VivaanRao-crisp/autoRAD/iteration_log.md

# Iteration log (CLAUDE.md rule 4)

Earlier changes (design-study revisions 1–3) are in `CHANGELOG.md`. From here on, every design
change goes in this file: date, what changed, why, which part to reprint.

| date | what changed | why | reprint |
|---|---|---|---|
| 2026-11-10 | Architecture D kinematics verified before CAD (`kinematics_D.py`, `docs/kinematics_D_report.md`, plots in `docs/img/`). Arm 70.0 → **70.3 mm**, link 60 → **70 mm**, arm elevation at closed 0 → **25°**; carriage moves **down** on payout (fixed pulleys below the carriage); carriage pulleys 2 rows of 2 (70 mm), not 4 in a row (150 mm > 149 mm housing). | Start values gave 32.4 mm of carriage travel (stop at 259 mm, not 300) and a 13.6 % non-linear mapping; joint direction in buildability.md was a sign error. | nothing printed yet |
| 2026-11-10 | 3D stack re-ordered to arm R / link R / link L / arm L (`D_STACK`); grips brought to a common plane z = 14.45 by 10.45 mm hub extensions; reeving changed to crossed axles (moving pulleys axle along x, fixed along z), carriage block 98 mm, cable depth z 21-59; params: bearing 625ZZ defaults, pins/bosses, lanes, E marked legacy | reported stack put joint pins through the far arm (-9.6 mm); 2x2 in-plane reeving forms a closed loop; see docs/kinematics_D_report.md addendum | nothing printed yet |
| 2026-11-10 | OPEN: hand envelope (R35 assumption) overlaps the pivot hub by 12.9 mm; arm joint below the pivot line at full open. Proposals P1-P3 in the report; verified geometry unchanged pending review | check3d_D.py grip check | - |
| 2026-11-10 | Freeze run: arm elevation 25 -> 40 deg, arm 70.3 -> 72.75 (re-solved), hub R20 -> R10, cable z centre 43, fairlead pulley F0 + dead end at the fixed end, spring above the carriage, rods at x +/-57. NOT FROZEN: mapping 2.86 % > 2.5 %, spring-beside does not fit (moved above), depth 72 > 70. Fixes proposed in docs/design_freeze.md | reviewer instructions + stop conditions | nothing printed yet |
| 2026-11-10 | Applied defaults: arm elevation 40 -> 38 deg (arm 72.75 -> 72.05 mm, mapping error 2.86 % -> 2.4 %, PASS), pulley width 8 -> 7 mm (depth 71.5 mm, not 70). CAD route changed: instructor rejects Python files, team builds parametric model in GUI CAD; docs/cad_build_guide.md written. New issue found: pivot bolt M8 vs 625 bearing bore 5 (use plain hub or 608) | user decisions; freeze run stop conditions | nothing printed yet |
| 2026-11-10 | FINAL bench rig: n 8 -> 4 cord parts (3 x 625 bearings as pulleys), arm 72.05 -> 125.9 mm, elevation 38 -> 42 deg, link 70 -> 120 mm, carriage travel 37.5 -> 75 mm; one-piece handles (hub + drive arm + long arm + grip pad); cord system moved BEHIND the board (links sweep the fixed-standoff zone in front); carriage = Gamma plate on two bolts in two board slots; housing, anchor spring, guide rods, 7 printed pulleys dropped; 16 printed pieces from 5 models | manufacturer: too many parts; project is a proof of concept (PDF section 6, slide 12) | nothing printed yet |
| 2026-11-10 | STL / STEP export of the 5 bench models (`cad/bench_parts.py` → `exports/`, `parts_list.md`), with an STL acceptance check (`cad/check_stl.py`) and a 44-body assembly interference check (`cad/bench_assembly.py`, output in `out/`). Two changes against design_spec.md §2: **(1) handle: 90° countersink Ø11 on the back face of the joint hole** (joint pins become M5 countersunk screws); **(2) carriage: band hook = two Ø4 holes at (4, 54.5) and (4, −5.5)** instead of a notch at (8, 65). Both are ASSUMPTION values in `params.py`. | (1) handle R lies flat on the board, so a joint-pin head or nut behind it would be inside the board (the earlier 3D check had no board in it). (2) a Ø4 hole does not fit at the spec corner next to the guide-bolt hole, and from there the band is only ~12 mm long at closed (6× stretch to the stop); the lower hole gives ~73 → ~148 mm. | nothing printed yet |
| 2026-11-10 | OPEN, found by the assembly check, NOT changed: (a) right arm passes the left-handle spacer (OD 24) with **0.51 mm** at full open — bench_check 3b measured to the bolt (8.5 mm), not the spacer; (b) flange washers overlap the carriage post by 0.5 mm each (post leaves 0.5 mm per side, the stack needs flange 1 mm + washer); (c) F1 / F0 standoff lengths ignore the 1 mm flange, bearings sit 1 mm behind the lane plane; (d) wall beside the carriage pin hole is 1.35 mm (rule: ≥ 1.6); (e) handle bed footprint is 167 × 167, not "118 × 176". | see `out/bench_assembly_run.txt` | decide before printing |
