VivaanRao-crisp/autoRAD/docs/buy_list.md

# autoRAD bench rig — buy list

Everything is hardware-store grade; no part numbers. Quantities include no spares — add 20 %.
Where delivery is a risk, the "local substitute" column works for a bench demo.

| # | Item | Spec | Qty | Local substitute if unavailable |
|---|---|---|---|---|
| 1 | Ball bearing | 625ZZ, 5 × 16 × 5 mm | 3 (+1 spare) | 626 (6 × 19 × 6) with M6 axles and bores changed to 6.3 — tell the CAD people; or printed plain pulleys (more friction) |
| 2 | Bolt M8 × 35, hex, with nut + 2 washers | pivot R | 1 | any M8 ≥ 30 |
| 3 | Bolt M8 × 50, hex, with nut + 2 washers | pivot L (through the 20.9 spacer) | 1 | any M8 ≥ 45 |
| 4 | Bolt M5 × 50, **flat/countersunk or button head** | carriage pin, F0 | 2 | M5 × 45–55 |
| 5 | Bolt M5 × 70, **flat head** | F1 | 1 | M5 × 65–75 |
| 6 | Bolt M5 × 45, flat head | dead end | 1 | M5 × 40–50 |
| 7 | Bolt M5 × 35 | carriage axle | 1 | M5 × 30–40 |
| 8 | Bolt M5 × 30 | guide bolt 2 | 1 | M5 × 25–35 |
| 9 | Bolt M5 × 25, **countersunk head** | joint pins (head flush in the handle's countersink, see design_spec §8a) | 2 | M5 × 20–30 countersunk |
| 10 | Nut M5 (nyloc preferred) | | 10 | plain nuts + a drop of glue |
| 11 | Washer M5 | | 10 | |
| 12 | Braided cord | 1–2 mm, low stretch (fishing braid, kite line, thin paracord) | 2 m | any thin non-stretch string |
| 13 | Rubber band / light bungee | 2–5 N pull over ~80 mm stretch | 3 | hair ties, chained rubber bands |
| 14 | Wooden dowel | Ø20 × 130 mm | 2 | broom handle offcut, PVC pipe Ø20–25 |
| 15 | Wood screws | 3.5 × 16 (dowel to grip pad) + 1 × (band screw) | 5 | |
| 16 | Board | plywood 12 mm (or acrylic 10 mm), 200 × 290 mm | 1 | MDF 12 mm; a cut-down shelf |
| 17 | Printing filament | PETG or PLA, ~110 g | — | |
| 18 | Anchor | a hook, door handle or shelf bracket above the bench to tie the cord to | 1 | a second person holding the cord |

Tools: drill with Ø5.5 and Ø8.5 bits (slots: drill a row of Ø5.5 holes and file to 5.3 wide, or
route), hacksaw, screwdrivers, M5/M8 spanners, ruler, protractor, a spring balance 0–10 N if you
can (for the force measurement; a kitchen scale pulling the cord works too).

If the bearings cannot be sourced in time: print plain pulleys Ø16 × 7 with a Ø5.3 bore on the
same bolts (the CAD people add one model). Friction rises; the demo still works.
