VivaanRao-crisp/autoRAD/autoRAD_Illustrations_Enhanced (1).pptx

IIT KANPUR / DEPARTMENT OF DESIGN

autoRAD

Automatically Articulating V-Bar Attachment
Travel-actuated main concept + spring-based Alpha iteration

Prasun Shrivastav · 230778 Suryansh Rastogi · 231059
Parth Arya Bhat · 230737 Preet Mehta · 230789
Vivaan Rao · 251192 Kamal Sahu · 261190605

01 / autoRAD

## Slide 2

DES649 / PROJECT PROPOSAL

The design opportunity

Rigid V-bar

Stable grip, but the included angle stays fixed throughout the pushdown.

Triceps rope

Hands can separate, but the motion is not mechanically guided.

Our objective

Guide both handles to open symmetrically as the attachment travels downward.

02 / autoRAD

## Slide 3

DES649 / PROJECT PROPOSAL

Problem statement & user need

A cable-machine user needs a stable attachment that accommodates changing hand positions during a pushdown, without a separate manual adjustment.

Design goals: automatic opening • symmetric movement • reversible operation • removable mounting

03 / autoRAD

## Slide 4

DES649 / PROJECT PROPOSAL

Concept evolution: Alpha → selected

ALPHA / spring-based

Self-contained articulated V-bar. User-generated outward force opens the handles against a torsion spring. Meshing gears synchronize the arms.
Simpler packaging, but not driven by pushdown position.

MAIN / travel-actuated

A frame-referenced secondary cable rotates a spool as the attachment moves downward. A linkage opens the handles symmetrically.
Return spring takes up slack during upward travel.

04 / autoRAD

## Slide 5

DES649 / PROJECT PROPOSAL

ALPHA / spring-resisted articulation

Concept A: user-driven opening; spring resists opening and returns arms on release.

WHAT DRIVES OPENING?

Outward force from the user

Meshing gears keep left/right handle motion symmetric.

Torsion spring supplies resistance and return torque — not displacement sensing.

REST / CLOSED

USER OPENS

45° preliminary

~110° preliminary

05 / autoRAD

## Slide 6

DES649 / PROJECT PROPOSAL

MAIN / travel-actuated opening

The spring rewinds / takes up secondary-cable slack as the attachment moves upward.

The fixed reference cable — not the return spring — couples machine travel to handle angle.

01 FRAME REFERENCE

Secondary cable terminates at a fixed anchor.

02 RELATIVE TRAVEL

Moving housing pulls cable from its spool.

03 ROTARY DRIVE

Spool turns the geared transmission.

04 HANDLE OPENING

Both handles flare symmetrically.

RETURN PATH

06 / autoRAD

## Slide 7

DES649 / PROJECT PROPOSAL

MAIN / mechanism & cable routing

Functional schematic — proportions, anchor height and cable path are conceptual until CAD verification.

MOVING HOUSING

PRIMARY CABLE

Fixed anchor

Provides displacement reference.

1

SECONDARY REFERENCE CABLE

SPOOL

DOWNWARD
TRAVEL

Spool + gearing

Converts payout to twin-handle rotation.

2

FIXED FRAME

Return spring

Rewinds slack during upward return.

3

07 / autoRAD

## Slide 8

DES649 / PROJECT PROPOSAL

MAIN / complete working cycle

Movement diagram emphasizes what moves, what stays fixed, and the return mechanism.

01 TOP

Cable wound

02 EARLY PUSH

Payout begins

03 MID STROKE

Spool rotates

04 BOTTOM

Opening limited

05 RETURN

Spring takes up

08 / autoRAD

## Slide 9

DES649 / PROJECT PROPOSAL

Opening angle increases with pushdown travel

Illustrative kinematic states: angle mapping requires spool diameter and gear-ratio calibration.

TOP OF STROKE

45°

MID-STROKE

80°

BOTTOM OF STROKE

110°

09 / autoRAD

## Slide 10

DES649 / PROJECT PROPOSAL

Preliminary design requirements

Geometry & travel

Included angle: approximately 45° to 110°
Travel: approximately 20–40 cm
Housing width target: ≤ 140 mm

Performance & safety

Symmetric handle motion
Actuation resistance goal: ≤ 10 N
Removable attachment; no frame drilling
Mechanical stops and guarded moving parts

10 / autoRAD

## Slide 11

DES649 / PROJECT PROPOSAL

Engineering challenges to resolve

Cable path

Avoid snagging and interference; ensure repeatable spool payout and take-up.

Human factors

Avoid forcing wrist motion; account for user height and stroke variation.

Mechanical integrity

Evaluate friction, backlash, gear loads, bearing support and safe end stops.

11 / autoRAD

## Slide 12

DES649 / PROJECT PROPOSAL

CAD → prototype → validation

CAD deliverables

Parametric assembly, exploded view, sectional views, spool sizing, gear ratio, clearance and motion study.

Physical validation

Low-load bench rig with fixed reference anchor; measure angle vs travel, actuation force, symmetry, return reliability and cable interference.

12 / autoRAD

## Slide 13

DES649 / PROJECT PROPOSAL

Comparative evaluation of both concepts

Alpha baseline

Measure manually applied opening force, spring torque, return repeatability and synchronization.

Selected main concept

Measure displacement-to-angle mapping, automatic opening, cable routing reliability and return take-up.

Compare on complexity, manufacturability, controllability, safety and user comfort.

13 / autoRAD

## Slide 14

DES649 / PROJECT PROPOSAL

Prior art, evidence & claims

Known: adjustable V-bars, ropes and swivel handles exist. Earlier proposal references US20200114193A1, US20020068666A1 and US5921902A.

Hypothesis: frame-referenced travel-to-opening actuation may distinguish this concept. Novelty, patentability and ergonomic benefits are NOT established.

Rendos et al. (2016), PMID 26694502: tested other handle conditions; does not validate autoRAD.

14 / autoRAD

## Slide 15

DES649 / PROJECT PROPOSAL

Project roadmap & deliverables

01 Model both alternatives and select linkage parameters
02 Simulate motion, packaging, interference and loading
03 Fabricate low-load Alpha and travel-actuated prototypes
04 Test → identify failure modes → revise CAD → retest
05 Deliver prototype, drawings, measurements and final report

DES649 requires a physical prototype and documented iteration; this presentation is a proposal, not a tested result.

15 / autoRAD

## Slide 16

DES649 / PROJECT PROPOSAL

autoRAD / design proposal

MAIN DESIGN
Secondary-cable, distance-based automatic opening

ALPHA DESIGN
Self-contained, spring-resisted articulation

16 / autoRAD
