VivaanRao-crisp/autoRAD/docs/img/bench_P1_handle.png

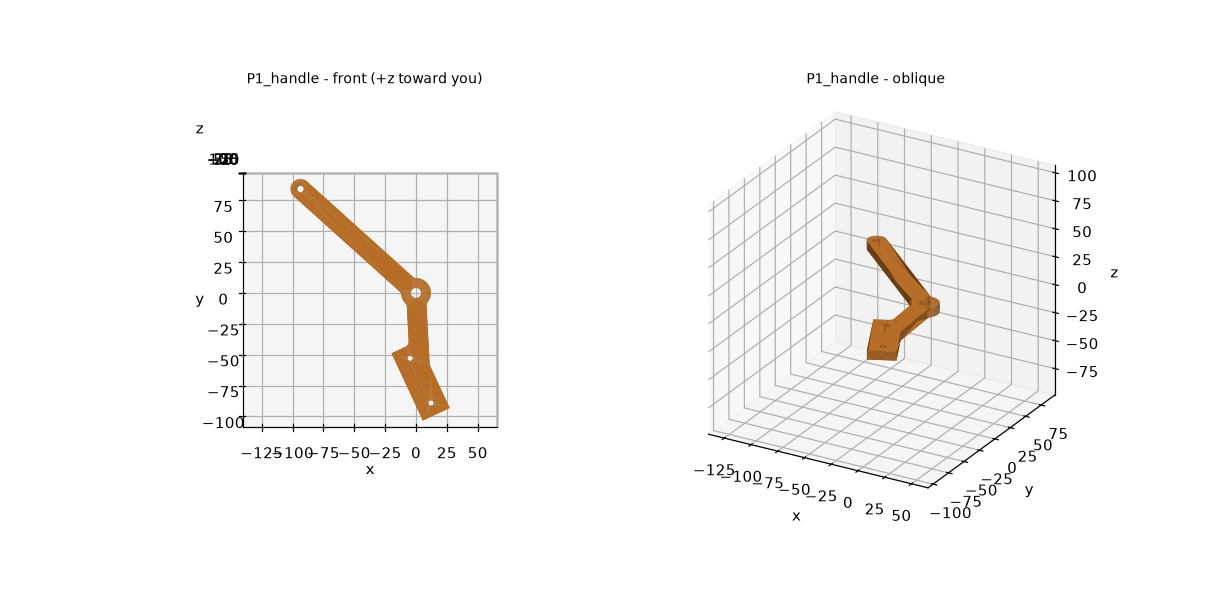
docs/img/bench_P1_handle.png
