VivaanRao-crisp/autoRAD/docs/img/bench_P2_link.png

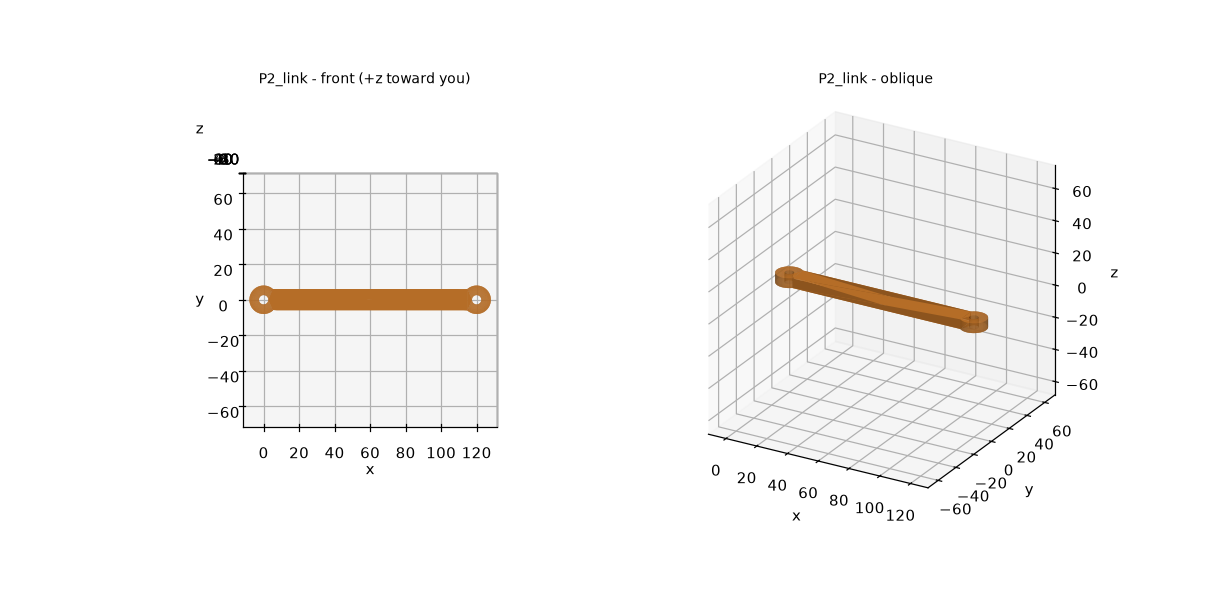
docs/img/bench_P2_link.png
