VivaanRao-crisp/autoRAD/docs/img/D_angle_vs_travel.png

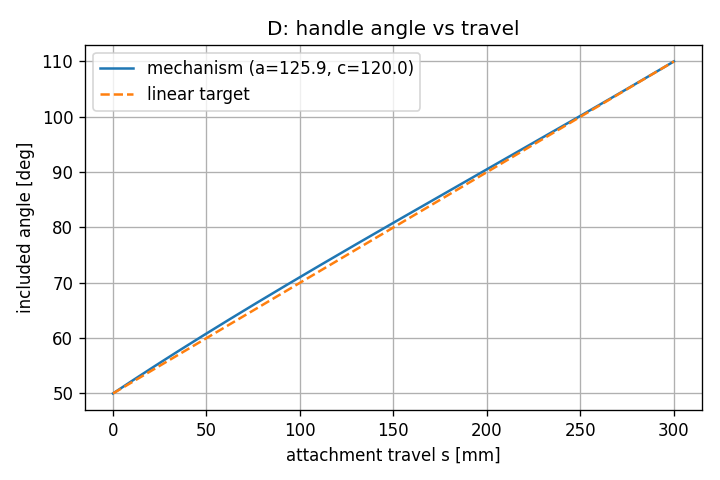
docs/img/D_angle_vs_travel.png
