VivaanRao-crisp/autoRAD/docs/img/D_cable_tension_vs_travel.png

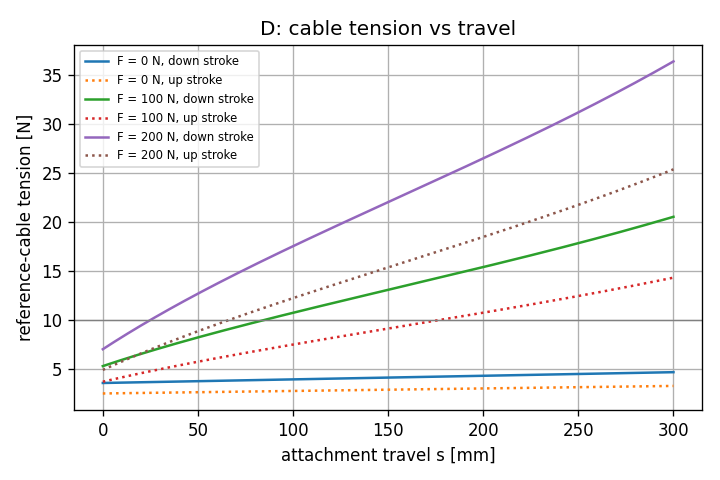
docs/img/D_cable_tension_vs_travel.png
