VivaanRao-crisp/autoRAD/docs/img/D_torque_vs_travel.png

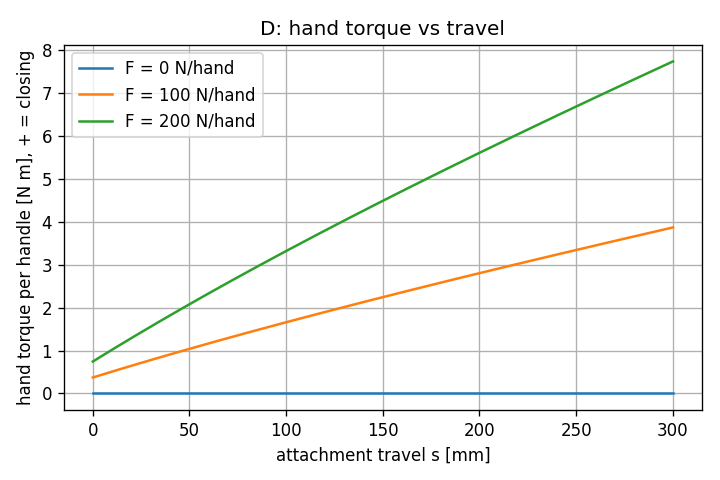
docs/img/D_torque_vs_travel.png
