VivaanRao-crisp/autoRAD/docs/img/D_transmission_angle_vs_travel.png

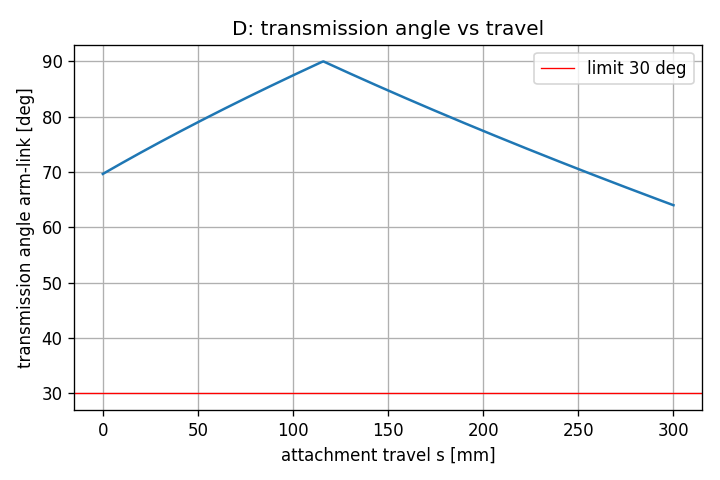
docs/img/D_transmission_angle_vs_travel.png
