VivaanRao-crisp/autoRAD/exports/step/assembly_closed.step

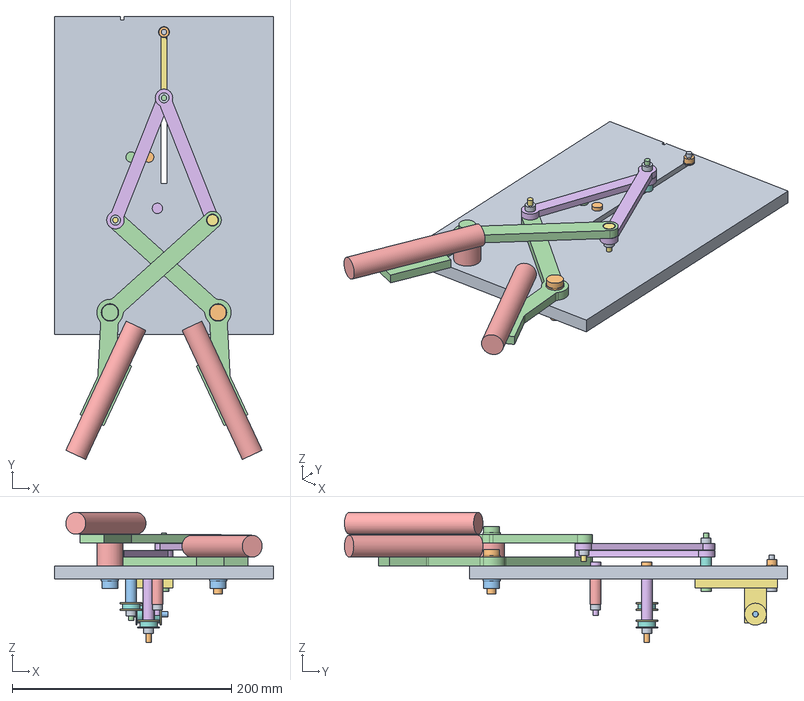
[picture p7: CAD file, 2026-11-11]
exports/step/assembly_closed.step
200.0 x 404.1 x 118.9 mm
board
pivot_R_bolt
pivot_R_nut
pivot_L_bolt
pivot_L_nut
spacer_handleL
F1_standoff
F1_flange_a
F1_bearing
F1_flange_b
F1_nut
F1_bolt
F0_standoff
F0_flange_a
F0_bearing
F0_flange_b
F0_nut
F0_bolt
dead_end_standoff
dead_end_nut
dead_end_bolt
carriage
carriage_pin_bolt
carriage_pin_nut
spacer_carriage_pin
guide_bolt
guide_nut
axle_bolt
M1_bearing
M1_flange_out
M1_flange_in
M2_bearing
M2_flange_out
M2_flange_in
handle_R
handle_L
dowel_R
dowel_L
link_R
link_L
joint_R_screw
joint_R_nut
joint_L_screw
joint_L_nut
