VivaanRao-crisp/autoRAD/exports/step/P1_handle.step

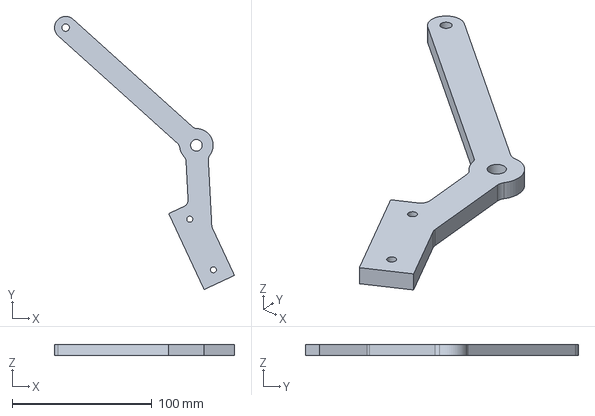
[picture p9: CAD file, 2026-11-11]
exports/step/P1_handle.step
128.8 x 195.5 x 8.00 mm
