VivaanRao-crisp/autoRAD/exports/step/P3_carriage.step

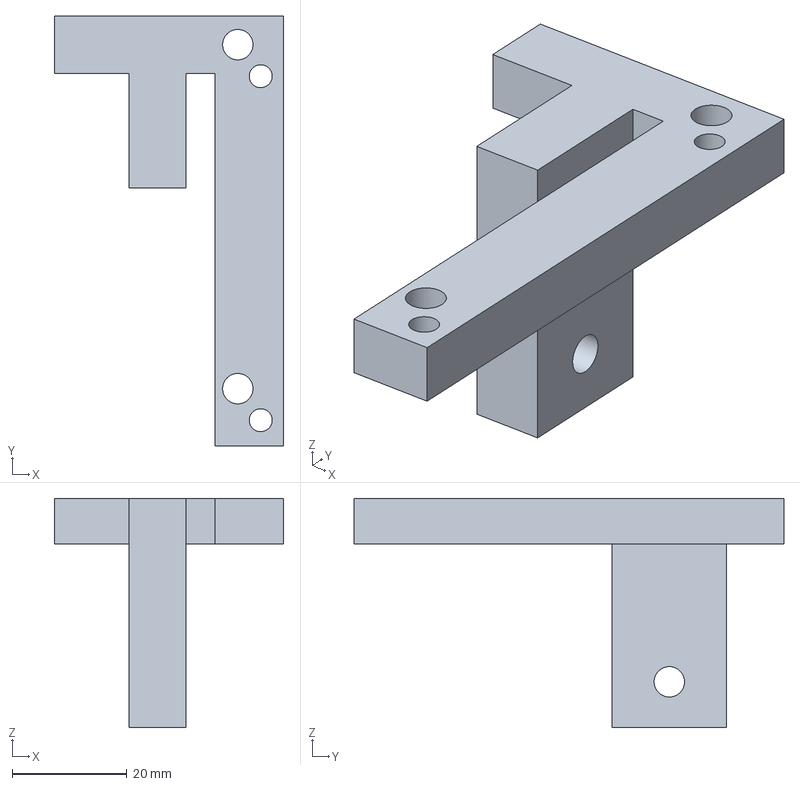
[picture p10: CAD file, 2026-11-11]
exports/step/P3_carriage.step
40.0 x 75.0 x 40.0 mm
