VivaanRao-crisp/autoRAD/exports/step/P4b_spacer_carriage_pin.step

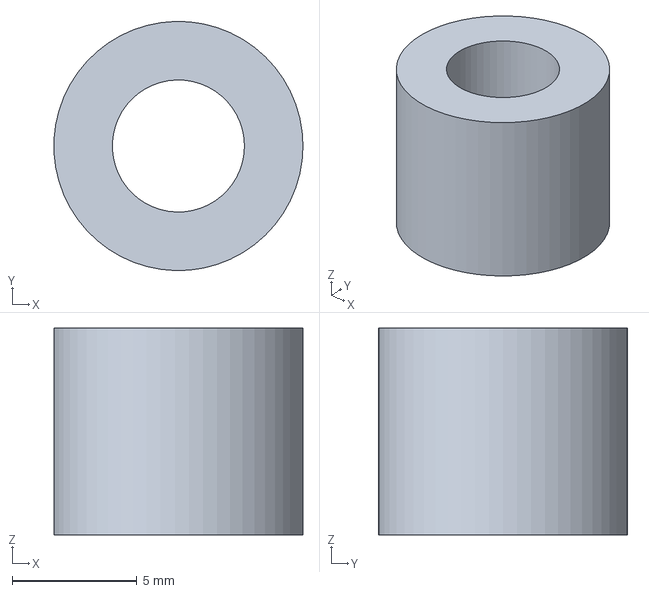
[picture p11: CAD file, 2026-11-11]
exports/step/P4b_spacer_carriage_pin.step
9.99 x 10.00 x 8.30 mm
