VivaanRao-crisp/autoRAD/exports/step/P4d_standoff_F0.step

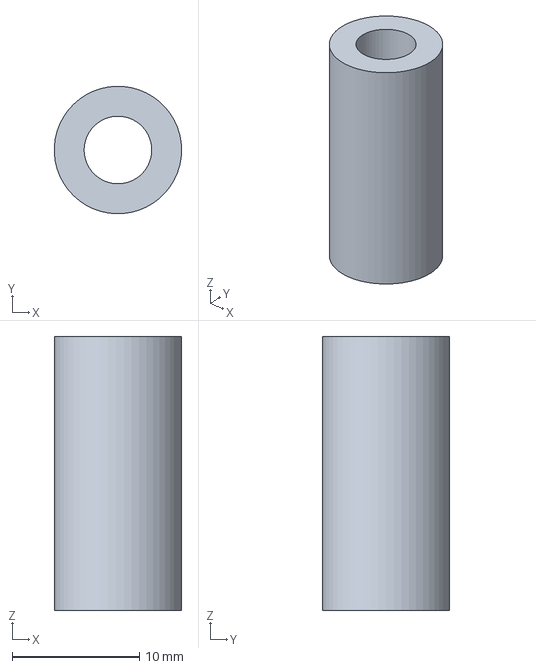
[picture p12: CAD file, 2026-11-11]
exports/step/P4d_standoff_F0.step
9.99 x 10.00 x 21.5 mm
