VivaanRao-crisp/autoRAD/exports/step/P4e_standoff_dead_end.step

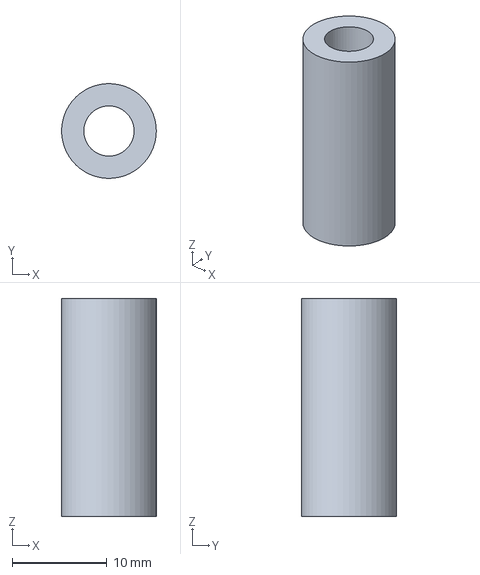
[picture p13: CAD file, 2026-11-11]
exports/step/P4e_standoff_dead_end.step
9.99 x 10.00 x 23.0 mm
