VivaanRao-crisp/autoRAD/exports/step/P4a_spacer_handleL.step

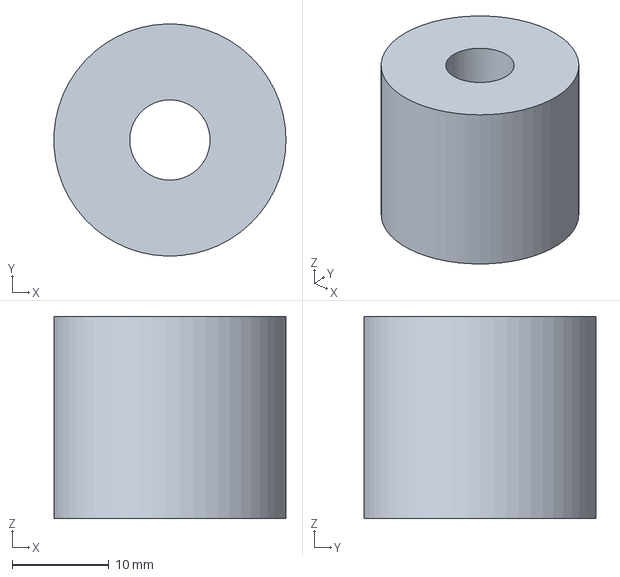
[picture p14: CAD file, 2026-11-11]
exports/step/P4a_spacer_handleL.step
24.0 x 24.0 x 20.9 mm
