VivaanRao-crisp/autoRAD/exports/step/optional_plain_pulley.step

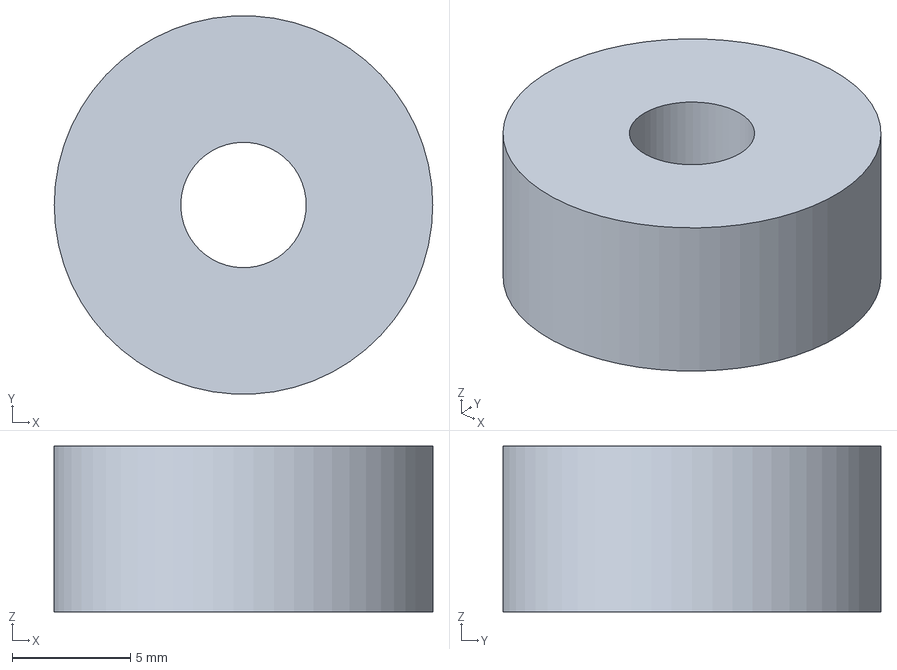
[picture p15: CAD file, 2026-11-11]
exports/step/optional_plain_pulley.step
16.0 x 16.0 x 7.00 mm
