VivaanRao-crisp/autoRAD/exports/step/P2_link.step

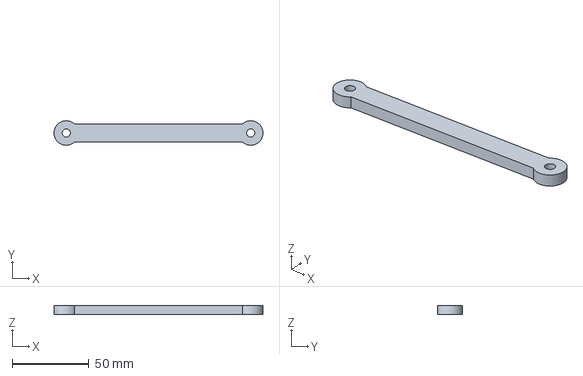
[picture p16: CAD file, 2026-11-11]
exports/step/P2_link.step
136.0 x 16.0 x 6.00 mm
