VivaanRao-crisp/autoRAD/exports/step/P4c_standoff_F1.step

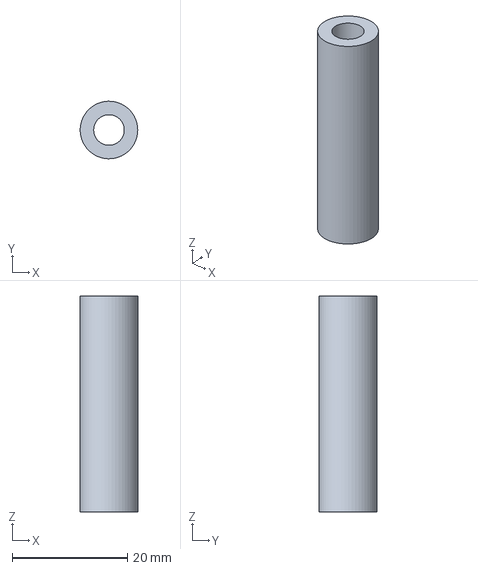
[picture p17: CAD file, 2026-11-11]
exports/step/P4c_standoff_F1.step
9.99 x 10.00 x 37.5 mm
