VivaanRao-crisp/autoRAD/exports/step/P5_flange_washer.step

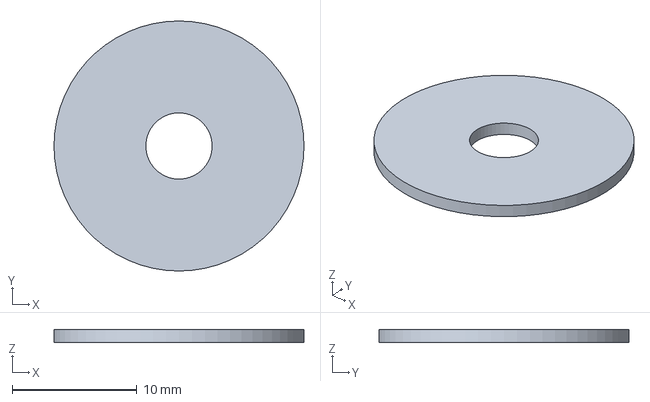
[picture p18: CAD file, 2026-11-11]
exports/step/P5_flange_washer.step
20.0 x 20.0 x 1.00 mm
