VivaanRao-crisp/autoRAD/(list of files, cad)

Other CAD files:
exports/stl/P1_handle.stl
exports/stl/P2_link.stl
exports/stl/P3_carriage.stl
exports/stl/P4a_spacer_handleL.stl
exports/stl/P4b_spacer_carriage_pin.stl
exports/stl/P4c_standoff_F1.stl
exports/stl/P4d_standoff_F0.stl
exports/stl/P4e_standoff_dead_end.stl
exports/stl/P5_flange_washer.stl
exports/stl/optional_plain_pulley.stl
