VivaanRao-crisp/autoRAD/docs/img/bench_assembly_closed.png

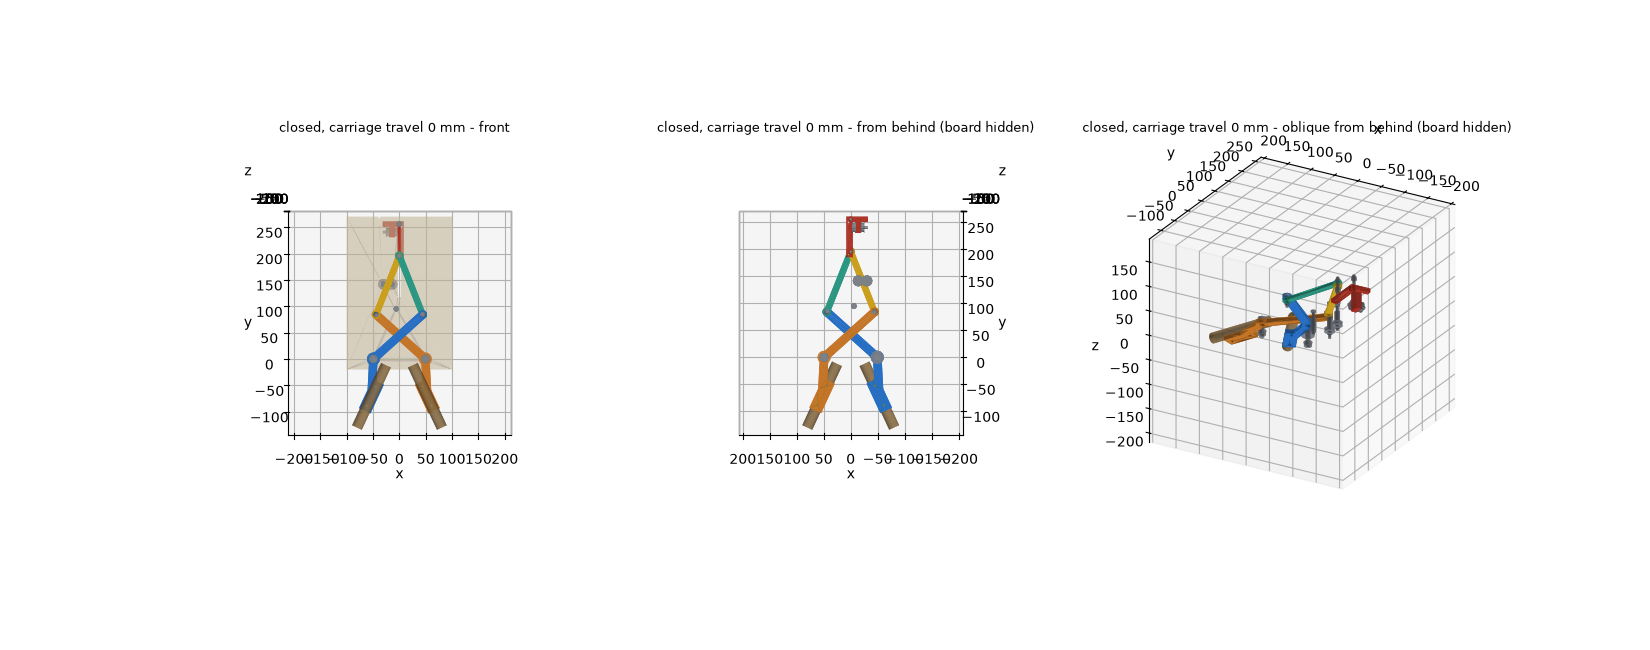
docs/img/bench_assembly_closed.png
